EricRollei/Burningman_Camp_Shower_Control/assets/Shower system - Amazon.com.pdf

### Shower system

Title | Comments Price Quantity Has
DC HOUSE 2 Pack 12V 30Ah LiFePO4 Battery with DC Port for Trolling Motor | Low Temp Cut-Off,
4000+ Deep Cycle Rechargeable Battery, Ideal for Lighting, Solar, Camping, Ham Radio, Ride on Toy
by DC HOUSE (Electronics) |
$139.99 | 1 | 0

RVBOATPAT Power Distribution Block 12V 150A 1/4" Stud Marine Bus Bar 12 Volt DC Battery Busbar for Boat Automotive Solar Wiring
by RVBOATPAT (Unknown Binding) |
$16.99 | 1 | 0
MENTBERY Heat Shrink Ring Terminals 16-14 AWG 1/4" Stud Wire Connectors | 50 PCS, M6 Stud,
Waterproof Insulated Ring Connectors Tinned Copper, 16-14 Gauge Blue
by MENTBERY (Misc.) |
$7.99 | 1 | 0

BNTECHGO 18 Gauge Silicone Wire Spool Red and Black Each 100ft Flexible 18 AWG Stranded Tinned
Copper Wire | Flexible 18 Gauge Stranded Wire Silicone Rubber Insulation For RC Models, Drone,
Robot, Battery, EV Charger, 3D Printer, DIY
by BNTECHGO (Misc.) |
$34.98 | 1 | 0

Bolipoeq 30Amp Circuit Breaker DC 12V-48V for Marine Boat Trolling Motor Automotive RV Trailer Car Solar System Battery Disconnect with Manual Reset Switch, IP67 Waterproof (Pack of 4)
by Bolipoeq |
$29.99 | 1 | 0

BNTECHGO 18 Gauge Silicone Wire Spool Red 25ft and Black 25ft 2 Separate Wires Flexible 18 AWG
Stranded Tinned Copper Wire | Flexible 18 AWG Stranded Tinned Copper Wire Silicone Rubber
Insulation For RC Models, Drone, Robot, EV Charger, 3D Printer
by BNTECHGO (Misc.) |
$13.98 | 1 | 0
MENTBERY Heat Shrink Ring Terminals 22-16 AWG 1/4" Stud Wire Connectors | 50 PCS, M6 Stud,
Waterproof Insulated Ring Connectors Tinned Copper, 22-16 Gauge Red
by MENTBERY (Misc.) |
$5.99 | 1 | 0

Gasedin 2PCS DC 12-24 V Voltmeter Gauge, Mini Digital Display LED Voltage Meter Gauge with Round Panel, Waterproof Battery Monitor Indicator for Car Boat Marine Truck (Green)
by Gasedin (Tools & Home Improvement) |
$8.99 | 1 | 0

BEYIMEI DC 12V to 5V USB Buck Converter, DC 12V 24V Step Down to USB C, Type C Buck Converter 3A 15W Output, Power Voltage Converters with Fuse for Type-C Port Devices
by BEYIMEI |
$13.99 | 1 | 0
PAEKQ SB50 Anderson Battery Quick Connect/Disconnect Connector Cable 7AWG | 50A, Anderson to
O-Ring Terminal Cable, Heavy-Duty,12V-72V, Wire Harness Plug Kit,For Car Winch Trailer Forklift,1Pair
by PAEKQ |
$16.99 | 1 | 0
Nilight 2 Pin DT Connectors 16AWG 6 Kits Male&Female Electrical Connector | Waterproof Plug and
Play w/Heat Shrink Butt Terminals for Automotive Cars Truck Motorcycle Marine Boats
by Nilight (Misc.) |
$12.30 | 1 | 0

Lever Wire Connectors, HTCELLE 60-Piece Quick Connect Electrical Splicing Kit for Compact Inline Terminals - 28-12 AWG, 1 in 1 Out (Multicolored, 60)
by HTCELLE (Misc.) |
$9.99 | 1 | 0

Gasedin 2PCS DC 12-24 V Voltmeter Gauge, Mini Digital Display LED Voltage Meter Gauge with Round Panel, Waterproof Battery Monitor Indicator for Car Boat Marine Truck (Red)
by Gasedin |
$8.54 | 1 | 0

DaierTek 12 Way Fuse Block, 12 Volt Blade Fuse Block with LED Indicator 12 Circuit Fuse Box 12V ATO/ATC Marine Fuse Panel 24V with Waterproof Cover Fuse Terminals for Automotive Boat Car RV by DAIERTEK (Misc.) |

$15.99 | 1 | 0

2 Pcs LM2596s DC Buck Converter, MELIFE Adjustable DC to DC Step-down Voltage Regulator Power Module 36V 24V 12V to 5V 2A Voltage Stabilizer with LED Display
by MELIFE (Personal Computers) |
- | 1 | 0

CAMPLUX Portable Tankless Water Heater, 1.58 GPM Outdoor Propane Water Heater with 3.54'' S/S Rain Cap, for Camping, 41,000 BTU, BD158C
by CAMPLUX ENJOY OUTDOOR LIFE |
$179.99 | 1 | 1

SEAFLO Accumulator Tank Water Pump Flow Control with Internal Bladder - 125 PSI, 23.5 oz (0.75 L) | Reduces Pump Cycling and Smooths Water Flow for Marine, RV, and Off-Grid Systems

- | 1 | 1

Blissland Shower Hose Extra Long 90 Inches Brushed Chrome Handheld Shower Head Hose with Brass Insert and Nut - Lightweight and Flexible
by Blissland (Tools & Home Improvement) |
$12.99 | 1 | 1

12V 20AH LiFePO4 Lithium Battery, Built-in 20A BMS, 5000+ Cycles Rechargeable Deep Cycle Battery, Perfect for Solar Power, Small UPS, Gate Opener, Fish Finder, Outdoor Camping

- | 1 | 1
USA Adventure Gear 3200 RV Water Pump | High Pressure Strong Flow | Quiet Operation |
Professional Grade Heavy Duty Construction | 3.2GPM 55PSI 12V DC 8A | Assembled in the USA Black
by USA Adventure Gear (Automotive) |
- | 1 | 0

5-pin 40/30Amp 12V DC Waterproof Automotive Relay with Heavy-Duty Wire
by iRhapsody (Tools & Home Improvement) |
$25.99 | 1 | 0
ECO-WORTHY 12V 10A Battery Charger for Lead-Acid, LiFePO4 Battery | Battery Maintainer, Trickle
Charger with LCD Screen for RV, Car, Motorcycle, Marine, Boat
by ECO-WORTHY |
$64.99 | 2 | 1
BesNPT 1/2" Male Thread Brass 3 Way Shut Off Valve Y Shaped Ball Valve | 3-Way Y Shaped 2 Switch
Ball Valve Solid Brass Corrosion Resistant Easy Installation
by BesNPT (Tools & Home Improvement) |
$13.99 | 1 | 0

SUNGATOR 1-Inch NPT Brass Hose Barb Fittings, 1'' NPT Male Thread to 1'' Barbed Air Hose Fittings, 1-Inch Brass Air Line Repair Connectors for Compressor, Fuel, Oil (2-Pack)
by SUNGATOR |
$10.99 | 1 | 0
DAVCO 1/2" ID 25 ft Reinforced Vinyl Tubing Clear PVC Suction Vacuum Hose | Flexible, non
collapsible, Heavy Duty, high pressure, Spiral steel wire reinforced vacuum line pipe, plastic tube, Non-Toxic
by DAVCO (Tools & Home Improvement) |
$25.99 | 1 | 0
Waterdrop 10UA Under Sink Water Filter System, NSF/ANSI 42 Certified 1 Year | Reduces PFAS,
PFOA/PFOS, Lead, Chlorine, Bad Taste & Odor, Under Counter Water Filter Connects Directly to Your Faucet
by Waterdrop (Tools & Home Improvement) |
$43.99 | 1 | 0

SNGSPK 304 Stainless Steel 5-Way Internal Threaded Connector - 1" NPT Multi-Branch - Precision CNC Machined for Industrial Pipeline Grid - Pack of 1
by SNGSPK (Tools & Home Improvement) |
- | 1 | 0

Shurflo 255-213 1/2" MNPT x FNPT Inline Strainer for 2088 Series Pumps
by SHURFLO (Tools & Home Improvement) |
$7.95 | 1 | 0

SEAFLO 42 Series 12V RV Water Pump, 3.0 GPM 55 PSI, 4-Year Warranty, On-Demand Fresh Water Pressure Pump with Bypass, Self-Priming for RVs, Boats, Marine & Off-Grid Use, UL Listed
by SEAFLO (Tools & Home Improvement) |
$64.99 | 1 | 0
Midanya 24" Sink Hose, 1/2" FIP x 1/2" FIP Faucet Supply Lines,2 Pcs | cUPC Stainless Steel
Braided,SUS304,for Bathroom,Kitchen,RV,Farmhouse,Easy Install,1 Pair Faucet Hose
by Midanya (Tools & Home Improvement) |
$11.99 | 1 | 0

See more (https://www.amazon.com/hz/wishlist/printview/MYFX98APBG9S?ajax=false&filter=unpurchased&sort=date-added)
