EricRollei/Burningman_Camp_Shower_Control/BOM.md

# Bill of Materials (BOM)

Per-shower bill of materials. The camp builds **two independent
stations**, so most quantities are **×2** (some multi-packs cover both).

> Status legend: ✅ selected · 🔍 searching · ❓ undecided · ⚠️ note / decision
>
> Prices are Amazon list prices (USD) captured from the
> [wishlist](https://www.amazon.com/hz/wishlist/ls/MYFX98APBG9S) and will
> drift. Items marked **(alt)** are alternatives not counted in the
> subtotal.

------------------------------------------------------------------------

## Power & Charging

| Item | Spec / Part | Qty | Status | Unit $ | Vendor / Link | Notes |
|---|---|:---:|:---:|:---:|---|---|
| Battery | DC HOUSE 12V 30Ah LiFePO₄ (2-pack) | 1 | ✅ | $139.99 /2-pack | [B0DHZPPKQS](https://www.amazon.com/dp/B0DHZPPKQS) | 2-pack covers both stations. Was speced 40Ah |
| Battery (alt) | 12V 20Ah LiFePO₄, built-in 20A BMS | — | 🔍 | — | [B0CY1RWLXR](https://www.amazon.com/dp/B0CY1RWLXR) | Smaller alternative |
| AC charger | ECO-WORTHY 12V 10A (Lead/LiFePO₄), LCD | 1 | ✅ | $64.99 | [B09ZQFDRZN](https://www.amazon.com/dp/B09ZQFDRZN) | Generator-fed |
| AC charger (alt) | ECO-WORTHY 12V 5A, LCD | — | 🔍 | $45.99 | [B08T95FF8K](https://www.amazon.com/dp/B08T95FF8K) | Slower alternative |
| Battery monitor | Gasedin mini LED voltmeter (2-pack, green) | 1 | ✅ | $8.99 /2-pack | [B0F4XGZVSP](https://www.amazon.com/dp/B0F4XGZVSP) | Voltage-only (not coulomb) |
| Battery monitor (alt) | Gasedin voltmeter (2-pack, red) | — | 🔍 | $8.54 /2-pack | [B0F4XBGJMV](https://www.amazon.com/dp/B0F4XBGJMV) | Color variant |
| Controller 5V supply | MELIFE LM2596 12V→5V buck (2-pack) | 1 | ✅ | see listing | [B08977C9YM](https://www.amazon.com/dp/B08977C9YM) | For 5V into PaHub (see open decision) |
| Solar panel | 50 W 12V | 1 | 🔍 | | | Not on list yet |
| Solar charge controller | 12V MPPT/PWM | 1 | 🔍 | | | Size to panel |

## Protection & Distribution

| Item | Spec / Part | Qty | Status | Unit $ | Vendor / Link | Notes |
|---|---|:---:|:---:|:---:|---|---|
| Main breaker | Bolipoeq 30A manual-reset (4-pack) | 1 | ✅ | $29.99 /4-pack | [B0DHCGYGJM](https://www.amazon.com/dp/B0DHCGYGJM) | Main disconnect; IP67 |
| Fuse block | DaierTek 12-way ATO/ATC, LED, waterproof | 1 | ✅ | $15.99 | [B0CGT91KTR](https://www.amazon.com/dp/B0CGT91KTR) | Fused branch distribution |
| Busbar | RVBOATPAT 150A 1/4" stud marine busbar | 1 | ✅ | $16.99 | [B0CF1N8FM8](https://www.amazon.com/dp/B0CF1N8FM8) | Negative / common bus |
| Fuses | ATO/ATC assortment (15/10/5/3–5A) | — | 🔍 | | | See Wiring.md |

## Pump & Plumbing (water path)

| Item | Spec / Part | Qty | Status | Unit $ | Vendor / Link | Notes |
|---|---|:---:|:---:|:---:|---|---|
| Pump | SEAFLO 42-Series 12V, 3.0 GPM, 55 PSI | 1 | ✅ | $64.99 | [B01CQ7DD0S](https://www.amazon.com/dp/B01CQ7DD0S) | UL listed; self-priming |
| Pump (alt) | USA Adventure Gear 3200, 3.2 GPM 55 PSI 8A | — | 🔍 | — | [B07BVSD4PF](https://www.amazon.com/dp/B07BVSD4PF) | Alternative pump |
| Accumulator | SEAFLO 0.75 L, 125 PSI | 1 | ✅ | $35.99 | [B01MUYL8F8](https://www.amazon.com/dp/B01MUYL8F8) | Smooths cycling |
| Inline strainer | Shurflo 255-213 1/2" for 2088 pumps | 1 | ✅ | $7.95 | [B00IU0N5ZO](https://www.amazon.com/dp/B00IU0N5ZO) | Pump-inlet filter |
| Water filter (opt) | Waterdrop 10UA under-sink | — | 🔍 | $43.99 | [B083NPW1DN](https://www.amazon.com/dp/B083NPW1DN) | Optional fine filter |
| Water heater | ⚠️ CAMPLUX tankless **propane**, 1.58 GPM, 41k BTU | 1 | ✅ | $179.99 | [B097JTWBGH](https://www.amazon.com/dp/B097JTWBGH) | Propane, not 12V — see note |
| Mixing valve | Thermostatic 1/2" NPT brass | 1 | ✅ | $29.99 | [B0C9TKWMN8](https://www.amazon.com/dp/B0C9TKWMN8) | Temp control |
| Flow sensor | SENSTREE G1/2" Hall, 1–30 L/min | 1 | ✅ | $8.99 | [B0CC949527](https://www.amazon.com/dp/B0CC949527) | Pulse output; Arduino-compatible |
| Foot pump (opt) | GHmarine 2147 manual, 1/2" hose | — | 🔍 | $29.99 | [B09VBX7ZDJ](https://www.amazon.com/dp/B09VBX7ZDJ) | Manual backup / sink |
| Tank | 500 gal (shared/camp) | 1 | ✅ | | | Shared resource |

## Plumbing Fittings & Hose

| Item | Spec / Part | Qty | Status | Unit $ | Vendor / Link | Notes |
|---|---|:---:|:---:|:---:|---|---|
| Cold-bypass valve | BesNPT 1/2" brass 3-way Y ball valve | 1 | ✅ | $13.99 | [B0CT8BL9V9](https://www.amazon.com/dp/B0CT8BL9V9) | Cold bypass / blend |
| Shower hose | Blissland 90" handheld, brushed chrome | 1 | ✅ | $12.99 | [B0B62QF1Q2](https://www.amazon.com/dp/B0B62QF1Q2) | |
| Supply hose | Midanya 24" 1/2" FIP braided (2-pack) | 1 | ✅ | $11.99 | [B0CZR5N4P3](https://www.amazon.com/dp/B0CZR5N4P3) | |
| Short supply hose | Midanya 9" 1/2" FIP × 1/2" FIP braided SS (2-pack) | 3 | ✅ | $12.59 /2-pack | [B0GT4WHS46](https://www.amazon.com/dp/B0GT4WHS46) | Need 5; 3 packs = 6 (1 spare) |
| Suction tubing | DAVCO 1/2" ID reinforced vinyl, 25 ft | 1 | ✅ | $25.99 | [B09W4KSB5X](https://www.amazon.com/dp/B09W4KSB5X) | Tank feed |
| Suction hose (1") | DAVCO 1" ID wire-reinforced PVC, 25 ft | 1 | ✅ | $44.99 | [B0F1TKPPDR](https://www.amazon.com/dp/B0F1TKPPDR) | Larger low-restriction tank suction |
| Hose barb | SUNGATOR 1" NPT male barb (2-pack) | 1 | ✅ | $10.99 | [B0CLY4WNJ7](https://www.amazon.com/dp/B0CLY4WNJ7) | Tank fitting |
| Manifold (opt) | SNGSPK 304 SS 5-way 1" NPT | — | 🔍 | — | [B0FLTW68VT](https://www.amazon.com/dp/B0FLTW68VT) | Distribution branch |

## Control Electronics

| Item | Spec / Part | Qty | Status | Unit $ | Vendor / Link | Notes |
|---|---|:---:|:---:|:---:|---|---|
| Controller | M5Stack Tough ESP32 (2.0" touch, IP-rated) | 1 | ✅ | $64.90 | [B0C7GL8RP8](https://www.amazon.com/dp/B0C7GL8RP8) | 12V via RS485 conn. |
| I²C hub | M5Stack PaHub v2.1 (PCA9548A, 6-port) | 1 | ✅ | $15.99 | [B0G5N1FSNG](https://www.amazon.com/dp/B0G5N1FSNG) | Grove I²C expansion |
| RFID/NFC reader | M5Stack RFID2 (WS1850S, 13.56 MHz) | 1 | ✅ | — | [B0F3N3XMDM](https://www.amazon.com/dp/B0F3N3XMDM) | MIFARE / NTAG compatible |
| Relay unit | M5Stack 4Relay (10A/16A, I²C) | 1 | ✅ | $29.99 | [B0H27XRW4T](https://www.amazon.com/dp/B0H27XRW4T) | Grove; incl. 3.96 terminals |
| Automotive relay | 5-pin 40/30A 12V waterproof, w/ harness | 1 | ✅ | $25.99 | [B074FSZWVT](https://www.amazon.com/dp/B074FSZWVT) | Pump switching |
| SD card | For CSV logs | 1 | 🔍 | | | Not on list |
| RTC | Real-time clock | 1 | ❓ | | | For log timestamps |

## Charging & Accessories

| Item | Spec / Part | Qty | Status | Unit $ | Vendor / Link | Notes |
|---|---|:---:|:---:|:---:|---|---|
| USB-C buck converter | BEYIMEI 12V→5V USB-C, 3A/15W, fused | 1 | ✅ | $13.99 | [B0D3THTQJK](https://www.amazon.com/dp/B0D3THTQJK) | Session-gated |
| USB-C panel outlet | | 1 | 🔍 | | | |
| LED strip | 12V addressable, 2 m | 1 | 🔍 | | | 120 individually addressable pixels confirmed on bench |

## Connectors, Wire & Terminals

| Item | Spec / Part | Qty | Status | Unit $ | Vendor / Link | Notes |
|---|---|:---:|:---:|:---:|---|---|
| Anderson SB50 | PAEKQ 50A cable, 7 AWG, O-ring (pair) | 1 | ✅ | $16.99 /pair | [B0F6L9L9GG](https://www.amazon.com/dp/B0F6L9L9GG) | Battery quick-disconnect |
| Deutsch DT (pump) | Nilight 2-pin DT 16 AWG (6 kits) | 1 | ✅ | $12.30 | [B0CMQHQ3LL](https://www.amazon.com/dp/B0CMQHQ3LL) | Waterproof |
| Lever connectors | HTCELLE 28-12 AWG splice kit (60 pc) | 1 | ✅ | $9.99 | [B0C3LBWSTZ](https://www.amazon.com/dp/B0C3LBWSTZ) | Quick splices |
| Silicone wire | BNTECHGO 18 AWG red+black, 100 ft ea | 1 | ✅ | $34.98 | [B091GHDSH8](https://www.amazon.com/dp/B091GHDSH8) | Controller power |
| Silicone wire | BNTECHGO 18 AWG red+black, 25 ft ea | 1 | ✅ | $13.98 | [B01C5CANVG](https://www.amazon.com/dp/B01C5CANVG) | Signals / jumpers |
| Ring terminals | MENTBERY 16-14 AWG 1/4" stud (50 pc, blue) | 1 | ✅ | $7.99 | [B0BWJ8G5P9](https://www.amazon.com/dp/B0BWJ8G5P9) | |
| Ring terminals | MENTBERY 22-16 AWG 1/4" stud (50 pc, red) | 1 | ✅ | $5.99 | [B0BWJ92F6G](https://www.amazon.com/dp/B0BWJ92F6G) | |
| SAE fused pigtail | BFXM 10 AWG SAE↔ring, 15/20A fuse (2-pack) | 1 | ✅ | $12.99 | [B0D66QVPQK](https://www.amazon.com/dp/B0D66QVPQK) | Quick-disconnect / solar / charger |
| MC4 (solar) | Solar connectors | 1 | 🔍 | | | Not on list |
| Grove | I²C device cables | — | 🔍 | | | Not on list |
| Wire 12/16 AWG | Power runs (pump/main/lighting) | — | 🔍 | | | See Wiring.md gauges |

Gauge plan (see [Wiring.md](Wiring.md)): battery/main & pump 12 AWG,
lighting 16 AWG, controller 18 AWG, signals 22 AWG.

## RFID / NFC Tags

| Tag | Purpose | Status | Unit $ | Vendor / Link |
|-----|---|:---:|:---:|---|
| NTAG213 | Candidate | 🔍 test | | |
| NTAG215 | Candidate | 🔍 test | | |
| NTAG216 | Candidate | 🔍 test | | |

------------------------------------------------------------------------

## Cost Summary

Selected primary items from the
[Amazon wishlist](https://www.amazon.com/hz/wishlist/ls/MYFX98APBG9S)
(list prices; **alt/optional** items excluded; some are multi-packs that
cover both stations):

| Subsystem | Selected items | Subtotal $ |
|---|---|---:|
| Power & charging | Battery 2-pack, 10A charger, voltmeter, LM2596 | 213.97* |
| Protection & distribution | 30A breaker 4-pack, 12-way fuse block, busbar | 62.97 |
| Pump & plumbing | Pump, accumulator, strainer, heater, mixing valve, flow sensor | 327.90 |
| Plumbing fittings & hose | Y valve, shower hose, supply hose, 3× 9" hose, tubing, 1" suction hose, hose barb | 158.71 |
| Control | M5Stack Tough, PaHub, RFID2, 4Relay, automotive relay | 136.87** |
| Accessories | USB-C buck converter | 13.99 |
| Connectors, wire, terminals | Anderson, DT, lever, SAE pigtail, 2× wire, 2× ring terminals | 115.21 |
| **Selected subtotal** | | **≈ $1,029.62** |

\* LM2596 price not shown on the wishlist; excluded from the number.
\*\* RFID2 price not shown on the wishlist; excluded from the number.

**Not yet on the list / still to source:** solar panel, solar charge
controller, SD card, RTC, USB-C panel outlet, LED strip, 12/16 AWG power
wire, MC4 & Grove connectors, ATO/ATC fuse assortment, NFC tags.

**Alternates & optional (not in subtotal):** 20Ah battery, 5A charger,
red voltmeter, USA Adventure Gear pump, Waterdrop under-sink filter,
GHmarine foot pump, SNGSPK 5-way manifold.
