EricRollei/Burningman_Camp_Shower_Control/firmware/shower-controller/src/main.cpp

#include <M5Unified.h>
#include <SD.h>
#include <Wire.h>
#include <WiFi.h>
#include <esp_system.h>
#include <esp_ota_ops.h>
#include <esp_task_wdt.h>

#include "AdminServer.h"
#include "CampNet.h"
#include "Config.h"
#include "FlowMeter.h"
#include "I2cHub.h"
#include "LightShow.h"
#include "MemberRegistry.h"
#include "PulseStorage.h"
#include "RelayController.h"
#include "RfidReader.h"
#include "SessionStorage.h"
#include "SettingsStore.h"
#include "SpeakerAudio.h"
#include "StationDisplay.h"
#include "StorageWrite.h"
#include "UsageLedger.h"

extern "C" bool verifyRollbackLater() { return true; }

namespace {
enum class ScreenState { IDLE, ACTIVE, MUSIC_CHANNEL, MESSAGE, CALIBRATION };

FlowMeter flow;
PulseStorage pulseStorage;
MemberRegistry members;
SessionStorage sessions;
SettingsStore settings;
SpeakerAudio speakerAudio;
UsageLedger ledger;
CampNetLink campNet(members, sessions, settings, ledger);
AdminServer admin(members, pulseStorage, sessions, settings, speakerAudio, ledger, campNet);
RelayController relays;
RfidReader rfid;
I2cHub i2cHub;
LightShow lightShow;
StationDisplay stationDisplay;

ScreenState screenState = ScreenState::IDLE;
char activeUid[21] = {0};
char activeName[33] = {0};
char lastScannedUid[21] = {0};
uint32_t lastScanMs = 0;
uint32_t lastRfidPollMs = 0;
uint32_t lastLogMs = 0;
uint32_t lastSensorTotal = 0;
uint32_t pendingPulses = 0;
uint32_t sessionPulses = 0;
uint32_t sessionStartMs = 0;
uint32_t messageUntilMs = 0;
uint32_t calibrationStartPulses = 0;
uint32_t calibrationStartMs = 0;
uint32_t lastBusProbeMs = 0;
uint32_t buttonChangedMs = 0;
uint32_t buttonPressedMs = 0;
uint32_t lastMusicKnobReadMs = 0;
uint32_t lastMusicKnobLogMs = 0;
uint32_t lastMusicStartAttemptMs = 0;
uint32_t lastMusicMovementMs = 0;
uint32_t musicChannelUntilMs = 0;
uint16_t musicKnobRaw = 0;
uint16_t musicMotionReferenceRaw = 0;
uint16_t musicCalibrationPositions[Config::MUSIC_KNOB_POSITION_COUNT] = {0};
float activeAllowance = 0.0F;
uint32_t activeTimeoutMs = 0;
float summaryGallons = 0.0F;
uint32_t summaryElapsedMs = 0;
// Camp-wide totals for the wristband that just finished (this station + every
// other station's last snapshot), shown on the summary screen.
float summaryTotalGallons = 0.0F;
uint32_t lastRemoteChangeCount = 0;
bool rfidReady = false;
bool relayReady = false;
bool hubReady = false;
uint8_t hubAddress = Config::PAHUB_ADDRESS;
int8_t relayChannel = -1;
int8_t rfidChannel = -1;
bool calibrationActive = false;
bool relayTestActive = false;
uint8_t relayTestChannel = 0;
uint32_t relayTestStartMs = 0;
bool pumpMaybeStuck = false;
uint32_t lastEmergencyRecoveryMs = 0;
uint8_t bootRelayState = 0;
bool bootRelayStateKnown = false;
bool screenDirty = true;
bool buttonRawPressed = false;
bool buttonStablePressed = false;
bool buttonPressArmed = false;
bool buttonStoppedPump = false;
char buttonPressUid[21] = {0};
bool musicStartPending = false;
bool musicKnobMoving = false;
bool musicStaticStarted = false;
bool musicCalibrationActive = false;
bool summaryReady = false;
bool summaryLogged = false;
bool otaPendingVerification = false;
uint32_t otaVerificationLoopStartMs = 0;
uint32_t otaLastRollbackAttemptMs = 0;
uint8_t musicCalibrationNextPosition = 0;
int8_t musicChannel = -1;
String musicCalibrationMessage = "Ready to calibrate";
String messageTitle;
String messageBody;
String serialCommand;

bool sessionActive() { return activeUid[0] != '\0'; }

void markRelayFailure() {
  // A failed write leaves the module latched in its last state; only a
  // successful all-off proves the pump is no longer powered.
  pumpMaybeStuck = !relays.allOff();
  relayReady = false;
}

bool setConfiguredRelay(uint8_t channel, bool on) {
  if (channel == 0) return true;
  if (!relayReady || !relays.set(channel, on)) {
    markRelayFailure();
    return false;
  }
  return true;
}

bool shutdownAllRelays() {
  if (!relayReady) return false;
  if (!relays.allOff()) {
    relayReady = false;
    pumpMaybeStuck = true;
    return false;
  }
  pumpMaybeStuck = false;
  return true;
}

bool applyAccessoryPolicy() {
  const SettingsStore::RelayConfig& config = settings.relayConfig();
  return !config.accessoryEnabled || config.accessory == 0 ||
         setConfiguredRelay(config.accessory, true);
}

void stopPump() {
  setConfiguredRelay(settings.relayConfig().pump, false);
}

void stopSessionOutputs() {
  const SettingsStore::RelayConfig& config = settings.relayConfig();
  if (!setConfiguredRelay(config.pump, false)) return;
  setConfiguredRelay(config.charger, false);
}

uint8_t doorDisplayState() {
  if (sessionActive()) return CampNet::DOOR_IN_USE;
  if (admin.otaMaintenanceActive() || calibrationActive || relayTestActive ||
      !pulseStorage.healthy() || !sessions.healthy() ||
      !settings.healthy() || !relayReady || !rfidReady) return CampNet::DOOR_UNAVAILABLE;
  return CampNet::DOOR_OPEN;
}

// Session limits for a wristband at this station: a member's own shower
// allowance (if set) overrides the shower limit; fills always use the role
// limit. Time limits always come from the role.
float effectiveAllowanceFor(const char* uid) {
  const float roleLimit = settings.roleLimits(Config::STATION_ROLE_VALUE).gallons;
  const float memberLimit = members.allowanceFor(uid);
  if (Config::IS_SHOWER && memberLimit > 0.0F) return memberLimit;
  return roleLimit > 0.0F ? roleLimit : Config::DEFAULT_ROLE_LIMIT_GALLONS[Config::STATION_ROLE_VALUE];
}

uint32_t effectiveTimeoutMs() {
  uint16_t minutes = settings.roleLimits(Config::STATION_ROLE_VALUE).minutes;
  if (minutes < Config::MIN_LIMIT_MINUTES || minutes > Config::MAX_LIMIT_MINUTES) {
    minutes = Config::DEFAULT_ROLE_LIMIT_MINUTES[Config::STATION_ROLE_VALUE];
  }
  return static_cast<uint32_t>(minutes) * 60UL * 1000UL;
}

void serviceCampNet() {
  campNet.setDoorState(doorDisplayState(), sessionActive());
  campNet.handle();
  ledger.handle();
  // Limits or members adopted from another station change what the idle
  // screen advertises.
  if (campNet.remoteChangeCount() != lastRemoteChangeCount) {
    lastRemoteChangeCount = campNet.remoteChangeCount();
    screenDirty = true;
  }
}

float gallonsFor(uint32_t pulses) {
  const float calibration = settings.pulsesPerGallon();
  return calibration > 0.0F ? pulses / calibration : 0.0F;
}

void setMessage(const String& title, const String& body, uint32_t durationMs = 3500) {
  summaryReady = false;
  messageTitle = title;
  messageBody = body;
  messageUntilMs = millis() + durationMs;
  screenState = ScreenState::MESSAGE;
  screenDirty = true;
  Serial.printf("[STATUS] %s: %s\n", title.c_str(), body.c_str());
}

String uidToHex(const uint8_t* uid, int length) {
  char hex[21] = {0};
  for (int i = 0; i < length && i < 10; ++i) snprintf(hex + i * 2, sizeof(hex) - i * 2, "%02X", uid[i]);
  return String(hex);
}

bool displayReady() {
  return pulseStorage.healthy() && sessions.healthy() && settings.healthy() &&
         relayReady && rfidReady;
}

void drawScreen() {
  const bool ready = displayReady();
  const uint8_t peers = campNet.peerCount();
  if (screenState == ScreenState::IDLE) {
    stationDisplay.drawIdle(Config::STATION_ROLE_VALUE, ready, peers);
  } else if (screenState == ScreenState::ACTIVE) {
    const bool pumpOn = relays.isOn(settings.relayConfig().pump);
    const float burnTotal = sessions.gallonsFor(activeUid) +
                            ledger.remoteGallonsFor(activeUid);
    stationDisplay.drawSession(Config::STATION_ROLE_VALUE, activeName, burnTotal,
                               gallonsFor(sessionPulses), millis() - sessionStartMs,
                               pumpOn, ready, peers);
  } else if (screenState == ScreenState::MUSIC_CHANNEL) {
    const uint8_t channel = musicChannel >= 0 ?
        static_cast<uint8_t>(musicChannel) : 0;
    stationDisplay.drawMusicChannel(
        Config::STATION_ROLE_VALUE, channel,
        Config::MUSIC_CHANNEL_NAMES[channel],
        relays.isOn(settings.relayConfig().pump), ready, peers);
  } else if (screenState == ScreenState::CALIBRATION) {
    const uint32_t pulses = flow.totalPulses() - calibrationStartPulses;
    stationDisplay.drawCalibration(pulses, ready, peers);
  } else {
    if (summaryReady) {
      stationDisplay.drawSummary(Config::STATION_ROLE_VALUE, summaryGallons,
                                 summaryTotalGallons, summaryElapsedMs,
                                 summaryLogged, ready, peers);
    } else {
      stationDisplay.drawMessage(Config::STATION_ROLE_VALUE, messageTitle,
                                 messageBody, ready, peers);
    }
  }
  screenDirty = false;
}

void discoverI2cDevices() {
  if (!hubReady) {
    for (uint8_t address = 0x70; address <= 0x77 && !hubReady; ++address) {
      hubReady = i2cHub.begin(Wire, address);
      if (hubReady) hubAddress = address;
    }
  }
  if (!hubReady) return;

  if (!relayReady) {
    relayChannel = i2cHub.findDevice(Config::RELAY_ADDRESS);
    relayReady = relayChannel >= 0 && relays.begin(Wire, Config::RELAY_ADDRESS, &i2cHub, relayChannel);
    if (relayReady && !applyAccessoryPolicy()) relayReady = false;
  }
  if (!rfidReady) {
    rfidChannel = i2cHub.findDevice(Config::RFID_ADDRESS);
    rfidReady = rfidChannel >= 0 && rfid.begin(Wire, Config::RFID_ADDRESS, &i2cHub, rfidChannel);
  }
}

void serviceI2cRecovery() {
  if (millis() - lastBusProbeMs < 5000 || sessionActive() || calibrationActive ||
      relayTestActive || pumpMaybeStuck) return;
  lastBusProbeMs = millis();
  // A reader that lost power comes back with its antenna off and reads 0
  // forever unless begin() runs again.
  if (rfidReady && !rfid.healthy()) {
    Serial.println("[I2C] RFID reader stopped responding; re-initialising");
    rfidReady = false;
  }
  if (hubReady && relayReady && rfidReady) return;
  // Re-open the hub before probing: a NACK latches I2cHub::healthy_ false (so
  // findDevice() always fails) and a re-plugged PaHUB resets its channel
  // register while the cached selectedChannel_ still says otherwise.
  if (hubReady) hubReady = i2cHub.begin(Wire, hubAddress);
  discoverI2cDevices();
}

bool flushPulses() {
  if (!sessionActive() || pendingPulses == 0) return true;
  const uint32_t delta = pendingPulses;
  if (!pulseStorage.recordPulses(activeUid, delta)) return false;
  pendingPulses = 0;
  return true;
}

void endSession(const char* reason) {
  if (!sessionActive()) return;
  stopSessionOutputs();
  if (Config::HAS_MUSIC) speakerAudio.stop();
  musicStartPending = false;
  musicKnobMoving = false;
  musicStaticStarted = false;
  musicMotionReferenceRaw = musicKnobRaw;
  const bool rawLogged = flushPulses() && pulseStorage.endTag(activeUid);
  const uint32_t endMs = millis();
  summaryGallons = gallonsFor(sessionPulses);
  summaryElapsedMs = endMs - sessionStartMs;
  const bool sessionLogged = sessions.append(sessionStartMs, endMs, activeUid,
                                             sessionPulses, summaryGallons,
                                             activeAllowance, reason);
  const bool logged = rawLogged && sessionLogged;
  // Camp-wide total: this station's completed sessions (now including this
  // one) plus the latest snapshot from every other station.
  summaryTotalGallons = sessions.gallonsFor(activeUid) +
                        ledger.remoteGallonsFor(activeUid);
  campNet.markUsageDirty();
  Serial.printf("[SESSION] end uid=%s pulses=%lu gallons=%.4f reason=%s logged=%s total=%.2f\n",
                activeUid, static_cast<unsigned long>(sessionPulses), summaryGallons,
                reason, logged ? "yes" : "no", summaryTotalGallons);
  activeUid[0] = '\0'; activeName[0] = '\0'; pendingPulses = 0; sessionPulses = 0;
  setMessage(logged ? Config::ROLE_COMPLETE_LABELS[Config::STATION_ROLE_VALUE] : "LOGGING ERROR",
             logged ? "Thank you!" : "Tell a camp admin", Config::SUMMARY_DISPLAY_MS);
  summaryLogged = logged;
  summaryReady = true;
}

void rebootController(const char* source) {
  Serial.printf("[SYSTEM] reboot requested from %s\n", source);
  if (sessionActive()) endSession("REBOOT");
  shutdownAllRelays();
  admin.handle();  // Give a pending HTTP response a chance to flush.
  delay(250);
  ESP.restart();
}

// Safety path: relay control was lost while water could be flowing (active
// session, calibration, or relay test), or a pump-off write was never
// confirmed. Keeps retrying until the module answers again; a successful
// RelayController::begin() forces every output off, which is the pump kill.
void serviceRelayEmergency() {
  const bool outputsInUse = sessionActive() || calibrationActive || relayTestActive;
  const bool controlLost = !relayReady || !hubReady;
  if (!pumpMaybeStuck && !(controlLost && outputsInUse)) return;
  const uint32_t now = millis();
  if (now - lastEmergencyRecoveryMs < Config::RELAY_EMERGENCY_RETRY_MS) return;
  lastEmergencyRecoveryMs = now;
  Serial.printf("[SAFETY] relay recovery: hub=%s relay=%s stuck=%s session=%s\n",
                hubReady ? "ok" : "fail", relayReady ? "ok" : "fail",
                pumpMaybeStuck ? "yes" : "no", sessionActive() ? "yes" : "no");

  Wire.beginTransmission(hubAddress);
  if (Wire.endTransmission() != 0) {
    i2cBusRecover(Wire, Config::I2C_SDA, Config::I2C_SCL, Config::I2C_FREQUENCY);
  }
  hubReady = i2cHub.begin(Wire, hubAddress);
  if (!hubReady) {
    for (uint8_t address = 0x70; address <= 0x77 && !hubReady; ++address) {
      hubReady = i2cHub.begin(Wire, address);
      if (hubReady) hubAddress = address;
    }
  }
  relayReady = false;
  if (hubReady) {
    relayChannel = i2cHub.findDevice(Config::RELAY_ADDRESS);
    relayReady = relayChannel >= 0 &&
                 relays.begin(Wire, Config::RELAY_ADDRESS, &i2cHub, relayChannel);
  }
  if (!relayReady) return;  // keep retrying on the next cadence tick
  pumpMaybeStuck = false;
  Serial.println("[SAFETY] relay control recovered; all outputs forced off");
  if (relayTestActive) {
    relayTestActive = false;
    relayTestChannel = 0;
  }
  if (calibrationActive) {
    calibrationActive = false;
    admin.reportCalibration(false, 0, "Stopped by relay recovery");
  }
  if (sessionActive()) endSession("RELAY_RECOVERY");
  if (!applyAccessoryPolicy()) relayReady = false;
  screenDirty = true;
}

void serviceOtaBootVerification() {
  if (!otaPendingVerification) return;
  const uint32_t now = millis();
  if (otaVerificationLoopStartMs == 0) otaVerificationLoopStartMs = now;
  if (now - otaVerificationLoopStartMs >= Config::OTA_HEALTHY_AFTER_MS &&
      campNet.ready() && admin.started()) {
    const esp_err_t result = esp_ota_mark_app_valid_cancel_rollback();
    if (result == ESP_OK) {
      otaPendingVerification = false;
      Serial.printf("[OTA] boot verified commit=%s dirty=%s\n",
                    Config::FIRMWARE_COMMIT, Config::FIRMWARE_DIRTY ? "yes" : "no");
    } else {
      Serial.printf("[OTA] could not mark image valid: %s\n", esp_err_to_name(result));
    }
    return;
  }
  if (now < Config::OTA_ROLLBACK_AFTER_MS) return;
  if (otaLastRollbackAttemptMs != 0 && now - otaLastRollbackAttemptMs < 5000) return;
  otaLastRollbackAttemptMs = now;
  Serial.println("[OTA] boot health deadline missed; rolling back");
  if (Config::HAS_MUSIC) speakerAudio.stop();
  shutdownAllRelays();
  const esp_err_t result = esp_ota_mark_app_invalid_rollback_and_reboot();
  Serial.printf("[OTA] rollback failed: %s\n", esp_err_to_name(result));
  setMessage("UPDATE FAILED", "USB recovery required", 30000);
}

bool serviceOtaLifecycle() {
  if (admin.takeOtaPrepareRequest()) {
    if (Config::HAS_MUSIC) speakerAudio.stop();
    musicStartPending = false;
    musicKnobMoving = false;
    musicStaticStarted = false;
    const bool relaysOff = shutdownAllRelays();
    if (Config::HAS_LED_STRIP) lightShow.handle(speakerAudio, false);
    setMessage(relaysOff ? "SOFTWARE UPDATE" : "UPDATE FAILED",
               relaysOff ? "Keep power on" : "Could not turn relays off",
               Config::OTA_ARM_TIMEOUT_MS + 10000UL);
    admin.confirmOtaPrepared(relaysOff);
  }

  if (admin.takeOtaRecoveryRequest()) {
    shutdownAllRelays();
    if (relayReady && !applyAccessoryPolicy()) relayReady = false;
    setMessage("UPDATE FAILED", "Old firmware is still active", 5000);
  }
  if (admin.takeOtaRebootRequest()) rebootController("OTA update");
  if (!admin.otaMaintenanceActive()) return false;

  if (Config::HAS_MUSIC) speakerAudio.stop();
  if (Config::HAS_LED_STRIP) lightShow.handle(speakerAudio, false);
  serviceCampNet();
  if (screenDirty) drawScreen();
  delay(5);
  return true;
}

void startSession(const String& uid) {
  const char* name = members.nameFor(uid.c_str());
  if (name == nullptr || !members.enabledFor(uid.c_str())) {
    summaryGallons = 0.0F; summaryElapsedMs = 0;
    setMessage("NOT AUTHORIZED", name ? "Wristband disabled" : "See a camp admin");
    return;
  }
  if (!pulseStorage.healthy() || !sessions.healthy() || !settings.healthy()) {
    summaryGallons = 0.0F; summaryElapsedMs = 0;
    setMessage("UNAVAILABLE", "Usage storage needs service");
    return;
  }
  // Authentication opens a session; an explicit physical or touchscreen
  // button activation starts water flow.
  if (!setConfiguredRelay(settings.relayConfig().pump, false)) {
    summaryGallons = 0.0F; summaryElapsedMs = 0;
    setMessage("UNAVAILABLE", "Pump control needs service");
    return;
  }
  strlcpy(activeUid, uid.c_str(), sizeof(activeUid));
  strlcpy(activeName, name, sizeof(activeName));
  activeAllowance = effectiveAllowanceFor(activeUid);
  activeTimeoutMs = effectiveTimeoutMs();
  pendingPulses = 0; sessionPulses = 0; sessionStartMs = millis(); lastLogMs = millis();
  if (!pulseStorage.selectTag(activeUid)) {
    stopSessionOutputs();
    activeUid[0] = '\0';
    activeName[0] = '\0';
    summaryGallons = 0.0F;
    summaryElapsedMs = 0;
    setMessage("UNAVAILABLE", "Could not start usage log");
    return;
  }
  if (!setConfiguredRelay(settings.relayConfig().charger, true)) {
    stopSessionOutputs();
    pulseStorage.endTag(activeUid);
    activeUid[0] = '\0';
    activeName[0] = '\0';
    summaryGallons = 0.0F;
    summaryElapsedMs = 0;
    setMessage("UNAVAILABLE", "Phone charger control needs service");
    return;
  }
  screenState = ScreenState::ACTIVE;
  screenDirty = true;
  Serial.printf("[SESSION] start uid=%s name=%s allowance=%.2f timeout_min=%lu relay=%u pump=off\n",
                activeUid, activeName, activeAllowance,
                static_cast<unsigned long>(activeTimeoutMs / 60000UL), settings.relayConfig().pump);
}

void pollFlow() {
  const uint32_t sensorTotal = flow.totalPulses();
  const uint32_t delta = sensorTotal - lastSensorTotal;
  lastSensorTotal = sensorTotal;
  if (delta == 0) return;
  if (sessionActive()) {
    pendingPulses += delta;
    sessionPulses += delta;
    screenDirty = true;
    if (gallonsFor(sessionPulses) >= activeAllowance) endSession("LIMIT");
  }
}

void pollRfid() {
  if (!rfidReady || relayTestActive || millis() - lastRfidPollMs < 80) return;
  lastRfidPollMs = millis();
  uint8_t uidBytes[10];
  const int length = rfid.readUid(uidBytes, sizeof(uidBytes));
  if (length <= 0) return;
  const String uid = uidToHex(uidBytes, length);
  const bool repeat = uid == lastScannedUid && millis() - lastScanMs < 2500;
  strlcpy(lastScannedUid, uid.c_str(), sizeof(lastScannedUid));
  lastScanMs = millis();
  rfid.haltTag();
  if (admin.onTagScanned(uid)) { setMessage("WRISTBAND ADDED", "Enrollment complete"); return; }
  if (repeat || calibrationActive) return;
  if (sessionActive()) {
    if (uid == activeUid) return;
    const char* name = members.nameFor(uid.c_str());
    if (name == nullptr || !members.enabledFor(uid.c_str())) {
      // An unknown tag must not end someone else's shower; just show the denial.
      setMessage("NOT AUTHORIZED", name ? "Wristband disabled" : "See a camp admin");
      screenState = ScreenState::ACTIVE;
      screenDirty = true;
      return;
    }
    // Someone forgot to log out: close their shower and log the new member in.
    endSession("HANDOFF");
  }
  startSession(uid);
}

void handleCalibration() {
  if (admin.takeCalibrationStartRequest()) {
    if (relayTestActive) {
      admin.reportCalibration(false, 0, "Finish the relay test first");
    } else if (sessionActive()) {
      admin.reportCalibration(false, 0, "Finish the active shower first");
    } else if (!setConfiguredRelay(settings.relayConfig().pump, true)) {
      stopPump();
      admin.reportCalibration(false, 0, "Pump control failed");
    } else {
      calibrationStartPulses = flow.totalPulses();
      calibrationStartMs = millis();
      calibrationActive = true;
      screenState = ScreenState::CALIBRATION;
      screenDirty = true;
      admin.reportCalibration(true, 0, "Dispensing into known container");
    }
  }
  if (calibrationActive) {
    const uint32_t pulses = flow.totalPulses() - calibrationStartPulses;
    admin.reportCalibration(true, pulses, "Dispensing into known container");
    static uint32_t lastCalibrationDraw = 0;
    if (millis() - lastCalibrationDraw > 250) { screenDirty = true; lastCalibrationDraw = millis(); }
    if (millis() - calibrationStartMs >= Config::MAX_CALIBRATION_MS) {
      stopPump();
      calibrationActive = false;
      admin.reportCalibration(false, pulses, "Safety timeout; value unchanged");
      setMessage("CALIBRATION STOPPED", "10 minute safety timeout");
    }
  }
  float knownGallons = 0.0F;
  if (admin.takeCalibrationStopRequest(knownGallons)) {
    if (!calibrationActive) {
      admin.reportCalibration(false, 0, "Calibration was not running");
      return;
    }
    stopPump();
    const uint32_t pulses = flow.totalPulses() - calibrationStartPulses;
    calibrationActive = false;
    if (pulses == 0 || knownGallons <= 0.0F) {
      admin.reportCalibration(false, pulses, "No pulses captured; value unchanged");
      setMessage("CALIBRATION FAILED", "No flow pulses captured");
      return;
    }
    const float ratio = pulses / knownGallons;
    const bool saved = settings.setCalibration(ratio);
    admin.reportCalibration(false, pulses, saved ? String("Saved ") + String(ratio, 2) + " pulses/gal" : "Could not save calibration");
    setMessage(saved ? "CALIBRATION SAVED" : "CALIBRATION FAILED",
               saved ? String(ratio, 1) + " pulses / gallon" : "Check SD card", 5000);
  }
}

void handleRelayAdmin() {
  if (admin.takeRelayPolicyApplyRequest() && relayReady) {
    shutdownAllRelays();
    if (relayReady) applyAccessoryPolicy();
  }

  uint8_t requestedChannel = 0;
  if (admin.takeRelayTestStartRequest(requestedChannel) && !sessionActive() &&
      !calibrationActive && !relayTestActive && relayReady) {
    shutdownAllRelays();
    if (relayReady && setConfiguredRelay(requestedChannel, true)) {
      relayTestActive = true;
      relayTestChannel = requestedChannel;
      relayTestStartMs = millis();
      Serial.printf("[RELAY] test channel=%u duration_ms=%lu\n", requestedChannel,
                    static_cast<unsigned long>(Config::RELAY_TEST_MS));
    }
  }

  const bool stopRequested = admin.takeRelayTestStopRequest();
  const bool timedOut = relayTestActive &&
                        millis() - relayTestStartMs >= Config::RELAY_TEST_MS;
  if (relayTestActive && (stopRequested || timedOut)) {
    shutdownAllRelays();
    relayTestActive = false;
    relayTestChannel = 0;
    if (relayReady) applyAccessoryPolicy();
    Serial.printf("[RELAY] test stopped reason=%s\n", timedOut ? "timeout" : "admin");
  }
}

// The physical GPIO button and touchscreen button share this lifecycle. The
// first activation starts the water; the next one ends the session (pump off).
void toggleShowerWater(const char* source, const char* endReason) {
  if (calibrationActive) {
    Serial.printf("[%s] ignored during calibration\n", source);
    return;
  }
  if (!sessionActive()) {
    Serial.printf("[%s] ignored; no authorized session\n", source);
    return;
  }

  if (relays.isOn(settings.relayConfig().pump)) {
    // Second activation: the shower is over. endSession() turns the pump off.
    Serial.printf("[%s] finish shower\n", source);
    endSession(endReason);
    return;
  }
  // First activation: start the water.
  if (!setConfiguredRelay(settings.relayConfig().pump, true)) {
    Serial.printf("[%s] pump relay write failed\n", source);
    endSession("RELAY_ERROR");
    return;
  }
  Serial.printf("[%s] pump=on\n", source);
  screenDirty = true;
}

void handlePumpButton() {
  const uint32_t now = millis();
  const bool pressed = digitalRead(Config::PUMP_BUTTON_PIN) == LOW;
  if (pressed != buttonRawPressed) {
    buttonRawPressed = pressed;
    buttonChangedMs = now;
  }
  if (now - buttonChangedMs < Config::BUTTON_DEBOUNCE_MS) return;

  if (pressed != buttonStablePressed) {
    buttonStablePressed = pressed;
    if (pressed) {
      buttonPressedMs = now;
      buttonPressArmed = true;
      buttonStoppedPump = sessionActive() &&
                          relays.isOn(settings.relayConfig().pump);
      strlcpy(buttonPressUid, activeUid, sizeof(buttonPressUid));
      // A possible long press must never leave water running while the user
      // waits for the five-second reboot threshold.
      if (buttonStoppedPump) {
        stopPump();
        screenDirty = true;
      }
      return;
    }

    if (!buttonPressArmed) return;
    buttonPressArmed = false;
    const bool sameSession = sessionActive() &&
                             strcmp(buttonPressUid, activeUid) == 0;
    if (!sameSession) return;
    if (buttonStoppedPump) {
      Serial.println("[BUTTON] finish shower");
      endSession("BUTTON");
    } else {
      toggleShowerWater("BUTTON", "BUTTON");
    }
    return;
  }

  if (buttonStablePressed && buttonPressArmed &&
      now - buttonPressedMs >= Config::BUTTON_REBOOT_HOLD_MS) {
    buttonPressArmed = false;
    rebootController("five-second physical button hold");
  }
}

void handleTouchButton() {
  if ((screenState != ScreenState::ACTIVE &&
       screenState != ScreenState::MUSIC_CHANNEL) || !sessionActive() ||
      calibrationActive || M5.Touch.getCount() == 0) return;

  const auto touch = M5.Touch.getDetail();
  if (!touch.wasClicked() ||
      !stationDisplay.controlButtonContains(touch.x, touch.y)) return;
  toggleShowerWater("TOUCH", "TOUCH");
}

void handleMusicKnob() {
  const uint32_t now = millis();
  if (now - lastMusicKnobReadMs < Config::MUSIC_KNOB_SAMPLE_MS) return;
  lastMusicKnobReadMs = now;

  const uint16_t sample = analogRead(Config::MUSIC_KNOB_PIN);
  // A small low-pass filter removes ADC noise without making the knob sluggish.
  musicKnobRaw = static_cast<uint16_t>(
      (static_cast<uint32_t>(musicKnobRaw) * 7U + sample) / 8U);

  if (admin.takeMusicCalibrationStartRequest()) {
    speakerAudio.stop();
    musicStartPending = false;
    musicKnobMoving = false;
    musicStaticStarted = false;
    musicMotionReferenceRaw = musicKnobRaw;
    musicChannel = 0;
    musicCalibrationActive = true;
    musicCalibrationNextPosition = 0;
    memset(musicCalibrationPositions, 0, sizeof(musicCalibrationPositions));
    musicCalibrationMessage = "Set knob to position 0, then capture";
    Serial.println("[MUSIC] calibration started; waiting for position 0");
  }
  if (admin.takeMusicCalibrationCancelRequest()) {
    musicCalibrationActive = false;
    musicCalibrationNextPosition = 0;
    musicChannel = -1;
    musicKnobMoving = false;
    musicStaticStarted = false;
    musicMotionReferenceRaw = musicKnobRaw;
    musicCalibrationMessage = "Calibration cancelled; previous values retained";
    Serial.println("[MUSIC] calibration cancelled");
  }
  if (admin.takeMusicCalibrationCaptureRequest() && musicCalibrationActive) {
    const uint8_t captured = musicCalibrationNextPosition;
    musicCalibrationPositions[captured] = musicKnobRaw;
    ++musicCalibrationNextPosition;
    Serial.printf("[MUSIC] calibration position=%u raw=%u\n", captured, musicKnobRaw);
    if (musicCalibrationNextPosition >= Config::MUSIC_KNOB_POSITION_COUNT) {
      if (settings.setMusicKnobCalibration(musicCalibrationPositions)) {
        musicCalibrationActive = false;
        musicCalibrationNextPosition = 0;
        musicChannel = -1;
        musicKnobMoving = false;
        musicStaticStarted = false;
        musicMotionReferenceRaw = musicKnobRaw;
        musicCalibrationMessage = "Saved positions 0-9";
        Serial.println("[MUSIC] calibration saved");
      } else {
        musicCalibrationNextPosition = 0;
        musicCalibrationMessage =
            "Invalid spacing or range; return to position 0 and recapture";
        Serial.println("[MUSIC] calibration rejected; points must be ordered and span at least 1000");
      }
    } else {
      musicCalibrationMessage = "Set knob to position " +
                                String(musicCalibrationNextPosition) +
                                ", then capture";
    }
  }

  if (musicCalibrationActive) {
    musicMotionReferenceRaw = musicKnobRaw;
  } else if (!sessionActive()) {
    // The selector is a camper control: while idle it only tracks its physical
    // position for telemetry. It must not start static, music, or lights.
    musicChannel = settings.nearestMusicPosition(musicKnobRaw);
    musicStartPending = false;
    musicKnobMoving = false;
    musicStaticStarted = false;
    musicMotionReferenceRaw = musicKnobRaw;
  } else {
    const uint16_t movement = static_cast<uint16_t>(abs(
        static_cast<int>(musicKnobRaw) -
        static_cast<int>(musicMotionReferenceRaw)));
    if (movement >= Config::MUSIC_KNOB_MOTION_THRESHOLD) {
      musicMotionReferenceRaw = musicKnobRaw;
      lastMusicMovementMs = now;
      if (!musicKnobMoving) {
        musicKnobMoving = true;
        musicStartPending = false;
        musicStaticStarted = speakerAudio.startRadioStatic();
        lastMusicStartAttemptMs = now;
        Serial.printf("[MUSIC] knob moving raw=%u; tuning static=%s\n",
                      musicKnobRaw, musicStaticStarted ? "on" : "waiting");
      }
    }

    if (musicKnobMoving && !musicStaticStarted &&
        now - lastMusicStartAttemptMs >= Config::MUSIC_KNOB_RETRY_MS) {
      lastMusicStartAttemptMs = now;
      musicStaticStarted = speakerAudio.startRadioStatic();
    }

    const bool settled = musicKnobMoving &&
                         now - lastMusicMovementMs >=
                             Config::MUSIC_KNOB_SETTLE_MS;
    if (settled || (!musicKnobMoving && musicChannel < 0)) {
      const int8_t previous = musicChannel;
      uint8_t candidate = settings.nearestMusicPosition(musicKnobRaw);
      if (!settings.musicKnobCalibrated() && musicChannel >= 0) {
        if (musicChannel == 0 && musicKnobRaw < Config::MUSIC_KNOB_ON_RAW)
          candidate = 0;
        if (musicChannel > 0 && musicKnobRaw > Config::MUSIC_KNOB_OFF_RAW)
          candidate = 1;
      } else if (settings.musicKnobCalibrated() && musicChannel >= 0 &&
                 candidate != static_cast<uint8_t>(musicChannel)) {
        const uint16_t currentDistance = static_cast<uint16_t>(abs(
            static_cast<int>(musicKnobRaw) -
            static_cast<int>(settings.musicKnobPosition(musicChannel))));
        const uint16_t candidateDistance = static_cast<uint16_t>(abs(
            static_cast<int>(musicKnobRaw) -
            static_cast<int>(settings.musicKnobPosition(candidate))));
        if (candidateDistance + Config::MUSIC_KNOB_CHANNEL_HYSTERESIS >=
            currentDistance) {
          candidate = static_cast<uint8_t>(musicChannel);
        }
      }

      musicKnobMoving = false;
      musicStaticStarted = false;
      musicMotionReferenceRaw = musicKnobRaw;
      musicChannel = candidate;
      musicStartPending = candidate > 0;
      lastMusicStartAttemptMs = now - Config::MUSIC_KNOB_RETRY_MS;
      if (candidate != static_cast<uint8_t>(previous)) {
        musicChannelUntilMs = now + Config::MUSIC_CHANNEL_DISPLAY_MS;
        screenState = ScreenState::MUSIC_CHANNEL;
        screenDirty = true;
      }
      if (candidate == 0) {
        speakerAudio.stop();
        Serial.printf("[MUSIC] knob settled raw=%u channel %d -> quiet\n",
                      musicKnobRaw, previous);
      } else {
        Serial.printf("[MUSIC] knob settled raw=%u channel %d -> %u (%s)\n",
                      musicKnobRaw, previous, candidate,
                      Config::MUSIC_CHANNEL_NAMES[candidate]);
      }
    }

    if (!musicKnobMoving && musicStartPending &&
        now - lastMusicStartAttemptMs >= Config::MUSIC_KNOB_RETRY_MS) {
      lastMusicStartAttemptMs = now;
      if (speakerAudio.playChannel(static_cast<uint8_t>(musicChannel))) {
        musicStartPending = false;
        Serial.printf("[MUSIC] channel=%d song started\n", musicChannel);
      } else {
        Serial.println("[MUSIC] waiting for speaker and channel file");
      }
    }
  }

  admin.reportMusicKnob(musicKnobRaw, musicChannel, musicCalibrationActive,
                        musicCalibrationNextPosition, musicCalibrationMessage);

  if (now - lastMusicKnobLogMs >= 1000) {
    lastMusicKnobLogMs = now;
    Serial.printf("[MUSIC] knob=%u/4095 channel=%d moving=%s calibrated=%s\n",
                  musicKnobRaw, musicChannel, musicKnobMoving ? "yes" : "no",
                  settings.musicKnobCalibrated() ? "yes" : "no");
  }
}

void reportAdminState() {
  admin.reportHardware(hubReady, relayReady, rfidReady);
  admin.reportOtaBootPending(otaPendingVerification);
  admin.reportRelays(relays.state(), relayTestActive, relayTestChannel);
  admin.reportSession(activeName, sessionActive() ? gallonsFor(sessionPulses) : 0.0F,
                      sessionActive() ? activeAllowance : 0.0F,
                      relayReady && relays.isOn(settings.relayConfig().pump),
                      doorDisplayState());
}

void serviceReliability() {
  const uint32_t now = millis();

  // The radio (soft-AP + ESP-NOW) and admin server retry at runtime instead of
  // staying dead until a reboot.
  static uint32_t lastAdminRetryMs = 0;
  if ((!campNet.ready() || !admin.started()) &&
      now - lastAdminRetryMs >= Config::ADMIN_RETRY_INTERVAL_MS) {
    lastAdminRetryMs = now;
    if (!campNet.ready()) {
      Serial.printf("[NET] retry %s\n", campNet.begin() ? "recovered" : "failed");
    }
    if (campNet.ready() && !admin.started()) {
      if (admin.begin()) {
        Serial.printf("[WEB] admin server recovered at http://%s/\n",
                      admin.address().c_str());
      } else {
        Serial.println("[WEB] admin server retry failed");
      }
    }
  }

  reportAdminState();
  // A remote END SESSION over CampNet can only stop water, never start it.
  if (admin.takeEndSessionRequest() && sessionActive()) endSession("REMOTE");
  if (admin.takeSpeakerSearchRequest() && Config::HAS_MUSIC) speakerAudio.requestDiscovery();
  if (admin.takeRebootRequest()) {
    rebootController("admin page");
  }

  static uint32_t lastHealthLogMs = 0;
  if (now - lastHealthLogMs >= Config::HEALTH_LOG_INTERVAL_MS) {
    lastHealthLogMs = now;
    Serial.printf("[HEALTH] uptime=%lus heap=%u min_heap=%u max_alloc=%u psram=%u wifi_clients=%u underruns=%lu net_peers=%u net_rx=%lu net_tx=%lu net_txfail=%lu net_rxdrop=%lu\n",
                  static_cast<unsigned long>(now / 1000), ESP.getFreeHeap(),
                  ESP.getMinFreeHeap(), ESP.getMaxAllocHeap(), ESP.getFreePsram(),
                  WiFi.softAPgetStationNum(),
                  static_cast<unsigned long>(speakerAudio.bufferUnderruns()),
                  static_cast<unsigned>(campNet.peerCount()),
                  static_cast<unsigned long>(campNet.rxPackets()),
                  static_cast<unsigned long>(campNet.txPackets()),
                  static_cast<unsigned long>(campNet.txFailures()),
                  static_cast<unsigned long>(campNet.rxDropped()));
  }
}

void printStatus() {
  Serial.printf("[STATION] id=%u role=%s name=%s ssid=%s channel=%u peers=%u members=%u/v%lu limits=v%lu\n",
                Config::STATION_ID_VALUE, CampNet::roleName(Config::STATION_ROLE_VALUE),
                Config::STATION_NAME, Config::WIFI_AP_NAME, CampNet::CHANNEL,
                static_cast<unsigned>(campNet.peerCount()), static_cast<unsigned>(members.count()),
                static_cast<unsigned long>(members.version()),
                static_cast<unsigned long>(settings.limitsVersion()));
  Serial.printf("[STATE] state=%u uid=%s pulses=%lu gallons=%.3f limit=%.2f relay=0x%02X sd=%s hub=%s@0x%02X relay_ch=%d rfid=%s rfid_ch=%d calibration=%.2f\n",
                static_cast<unsigned>(screenState), sessionActive() ? activeUid : "NONE",
                static_cast<unsigned long>(sessionPulses), gallonsFor(sessionPulses),
                activeAllowance, relays.state(), pulseStorage.healthy() ? "ok" : "fail",
                hubReady ? "ok" : "fail", hubAddress, relayChannel,
                rfidReady ? "ok" : "fail", rfidChannel, settings.pulsesPerGallon());
  const SettingsStore::RelayConfig& relayConfig = settings.relayConfig();
  Serial.printf("[RELAY] pump=%u charger=%u accessory=%u accessory_enabled=%s state=0x%02X test=%u\n",
                relayConfig.pump, relayConfig.charger, relayConfig.accessory,
                relayConfig.accessoryEnabled ? "yes" : "no", relays.state(),
                relayTestActive ? relayTestChannel : 0);
  Serial.printf("[MUSIC] knob=%u/4095 channel=%d calibrated=%s speaker=%s speaker_volume=%u%% playback=%s pcm_bass=%u pcm_mid=%u pcm_treble=%u pcm_volume=%u\n",
                musicKnobRaw, musicChannel,
                settings.musicKnobCalibrated() ? "yes" : "no",
                speakerAudio.connectionLabel(),
                speakerAudio.speakerVolumePercent(), speakerAudio.playbackLabel(),
                speakerAudio.bassLevel(), speakerAudio.midLevel(),
                speakerAudio.trebleLevel(), speakerAudio.volumeLevel());
}

void processSerialCommand(String command) {
  command.trim(); command.toLowerCase();
  if (command == "off") { if (sessionActive()) endSession("SERIAL"); else { stopSessionOutputs(); setMessage("WATER OFF", "Pump and charger stopped"); } }
  else if (command == "end") endSession("SERIAL");
  else if (command == "status") printStatus();
  else if (command == "tone") Serial.println(speakerAudio.playTestTone() ? "[AUDIO] tone requested" : "[AUDIO] speaker not connected");
  else if (command == "play") Serial.println(speakerAudio.playSong() ? "[AUDIO] song requested" : "[AUDIO] speaker/file unavailable");
  else if (command.length() == 5 && command.startsWith("play") &&
           command[4] >= '1' && command[4] <= '9') {
    const uint8_t channel = static_cast<uint8_t>(command[4] - '0');
    Serial.printf("[AUDIO] channel %u %s\n", channel,
                  speakerAudio.playChannel(channel) ? "requested" : "unavailable");
  }
  else if (command == "stop") speakerAudio.stop();
  else if (!command.isEmpty()) Serial.println("[HELP] commands: off end status tone play play1..play9 stop");
}

void handleSerial() {
  while (Serial.available()) {
    const char value = static_cast<char>(Serial.read());
    if (value == '\n' || value == '\r') { if (!serialCommand.isEmpty()) { processSerialCommand(serialCommand); serialCommand = ""; } }
    else if (serialCommand.length() < 32) serialCommand += value;
  }
}

const char* resetReasonName(esp_reset_reason_t reason) {
  switch (reason) {
    case ESP_RST_POWERON: return "POWERON";
    case ESP_RST_EXT: return "EXT";
    case ESP_RST_SW: return "SW";
    case ESP_RST_PANIC: return "PANIC";
    case ESP_RST_INT_WDT: return "INT_WDT";
    case ESP_RST_TASK_WDT: return "TASK_WDT";
    case ESP_RST_WDT: return "WDT";
    case ESP_RST_DEEPSLEEP: return "DEEPSLEEP";
    case ESP_RST_BROWNOUT: return "BROWNOUT";
    case ESP_RST_SDIO: return "SDIO";
    default: return "UNKNOWN";
  }
}

// One CSV row per boot: why the chip reset and whether the relay module was
// still driving the pump when we came up -- the forensic trail for crashes
// that never reach a serial monitor.
void appendBootLog(bool sdReady) {
  const char* reason = resetReasonName(esp_reset_reason());
  char stateCell[8];
  if (bootRelayStateKnown) {
    snprintf(stateCell, sizeof(stateCell), "0x%02X", bootRelayState);
  } else {
    strlcpy(stateCell, "NA", sizeof(stateCell));
  }
  const uint8_t pump = settings.relayConfig().pump;
  const bool pumpValid = bootRelayStateKnown && pump >= 1 && pump <= 4;
  const char* pumpCell = !pumpValid ? "NA"
      : (bootRelayState & (1U << (4U - pump))) != 0 ? "1" : "0";
  Serial.printf("[FORENSICS] reset=%s relay_at_boot=%s pump_latched=%s\n",
                reason, stateCell, pumpCell);
  if (!sdReady) return;
  if (!SD.exists(Config::BOOT_LOG_PATH)) {
    File file = SD.open(Config::BOOT_LOG_PATH, FILE_WRITE);
    if (!file) return;
    StorageWrite::line(file,
        "uptime_ms,reset_reason,relay_state_at_boot,pump_was_latched,hub,relay,rfid,sd");
    file.flush();
    file.close();
  }
  File file = SD.open(Config::BOOT_LOG_PATH, FILE_APPEND);
  if (!file) return;
  StorageWrite::formatted(file, "%lu,%s,%s,%s,%s,%s,%s,%s\n",
                          static_cast<unsigned long>(millis()), reason, stateCell,
                          pumpCell, hubReady ? "ok" : "fail",
                          relayReady ? "ok" : "fail", rfidReady ? "ok" : "fail",
                          sdReady ? "ok" : "fail");
  file.flush();
  file.close();
}
}

void setup() {
  Serial.begin(115200);
  delay(200);
  auto config = M5.config();
  M5.begin(config);
  // Start supervision before storage, I2C, radio, or Bluetooth setup so a bad
  // OTA image that wedges during setup is reset and the bootloader can revert.
  esp_task_wdt_init(Config::WDT_TIMEOUT_S, true);
  esp_task_wdt_add(nullptr);
  const esp_partition_t* runningPartition = esp_ota_get_running_partition();
  esp_ota_img_states_t otaState;
  otaPendingVerification = runningPartition != nullptr &&
                           esp_ota_get_state_partition(runningPartition, &otaState) == ESP_OK &&
                           otaState == ESP_OTA_IMG_PENDING_VERIFY;
  if (otaPendingVerification) Serial.println("[OTA] new image pending boot health verification");
  // Tough's AXP192 gates 5 V to the external HY2.0 ports. Keep Port A powered
  // explicitly before probing the PaHUB rather than relying on library defaults.
  M5.Power.setExtOutput(true);
  delay(150);

  // A watchdog reset does not power-cycle the external 4Relay module. Force it
  // off before display, SD replay, LEDs, radio or Bluetooth can delay boot.
  // A crashed transfer can leave a slave holding SDA low, which would block
  // the relay-off below; clock the bus clear before the first transaction.
  i2cBusRecover(Wire, Config::I2C_SDA, Config::I2C_SCL, Config::I2C_FREQUENCY);
  discoverI2cDevices();
  bootRelayStateKnown = relays.preClearStateKnown();
  bootRelayState = relays.preClearState();
  esp_task_wdt_reset();

  M5.Display.setRotation(1);
  stationDisplay.begin();
  pinMode(Config::PUMP_BUTTON_PIN, INPUT_PULLUP);
  buttonRawPressed = digitalRead(Config::PUMP_BUTTON_PIN) == LOW;
  buttonStablePressed = buttonRawPressed;
  buttonChangedMs = millis();
  if (Config::HAS_MUSIC) {
    pinMode(Config::MUSIC_KNOB_PIN, INPUT);
    analogReadResolution(12);
    analogSetPinAttenuation(Config::MUSIC_KNOB_PIN, ADC_11db);
    uint32_t initialKnobTotal = 0;
    for (uint8_t i = 0; i < 16; ++i) initialKnobTotal += analogRead(Config::MUSIC_KNOB_PIN);
    musicKnobRaw = static_cast<uint16_t>(initialKnobTotal / 16U);
    musicMotionReferenceRaw = musicKnobRaw;
  }
  if (Config::HAS_LED_STRIP) lightShow.begin();
  drawScreen();

  flow.begin(Config::FLOW_PIN);
  lastSensorTotal = flow.totalPulses();
  const bool sdReady = pulseStorage.begin();
  esp_task_wdt_reset();
  const bool membersReady = sdReady && members.begin();
  esp_task_wdt_reset();
  const bool settingsReady = sdReady && settings.begin();
  esp_task_wdt_reset();
  const bool sessionsReady = sdReady && sessions.begin();
  esp_task_wdt_reset();
  const bool ledgerReady = sdReady && ledger.begin();
  esp_task_wdt_reset();

  // Relay discovery used safe defaults above. Now that the saved mapping is
  // available, begin from all-off again and restore only configured accessory
  // power. Pump and charger remain off.
  shutdownAllRelays();
  if (relayReady && !applyAccessoryPolicy()) relayReady = false;
  appendBootLog(sdReady);
  const bool netReady = campNet.begin();
  const bool adminReady = netReady && admin.begin();
  esp_task_wdt_reset();
  bool audioReady = false;
  if (Config::HAS_MUSIC) {
    speakerAudio.setSpeakerVolumePercent(settings.speakerVolumePercent());
    audioReady = speakerAudio.begin();
    esp_task_wdt_reset();
  }

  Serial.printf("[BOOT] station=%u role=%s board=%u ext5v=%s sd=%s members=%s settings=%s sessions=%s ledger=%s hub=%s relay=%s rfid=%s net=%s admin=%s reset=%s\n",
                Config::STATION_ID_VALUE, CampNet::roleName(Config::STATION_ROLE_VALUE),
                static_cast<unsigned>(M5.getBoard()), M5.Power.getExtOutput()?"on":"off",
                sdReady?"ok":"fail", membersReady?"ok":"fail", settingsReady?"ok":"fail",
                sessionsReady?"ok":"fail", ledgerReady?"ok":"fail", hubReady?"ok":"fail",
                relayReady?"ok":"fail", rfidReady?"ok":"fail", netReady?"ok":"fail",
                adminReady?"ok":"fail", resetReasonName(esp_reset_reason()));
  Serial.printf("[WEB] ssid=%s address=http://%s/ page_password=%s\n", Config::WIFI_AP_NAME,
                admin.address().c_str(), Config::ADMIN_PAGE_PASSWORD ? "on" : "off");
  Serial.printf("[NET] channel=%u door_sign=%s members_version=%lu limits_version=%lu\n",
                CampNet::CHANNEL, Config::HAS_DOOR_SIGN ? "yes" : "no",
                static_cast<unsigned long>(members.version()),
                static_cast<unsigned long>(settings.limitsVersion()));
  if (Config::HAS_MUSIC) {
    Serial.printf("[AUDIO] source=%s file=%s path=%s\n", audioReady ? "ready" : "failed",
                  speakerAudio.fileAvailable() ? "ready" : "missing", Config::AUDIO_PATH);
    Serial.printf("[MUSIC] knob_pin=%u raw=%u on=%u off=%u\n", Config::MUSIC_KNOB_PIN,
                  musicKnobRaw, Config::MUSIC_KNOB_ON_RAW, Config::MUSIC_KNOB_OFF_RAW);
  } else {
    Serial.println("[AUDIO] disabled for this station role");
  }
  Serial.printf("[I2C] pahub_0x%02X=%s relay_0x26=ch%d rfid_0x28=ch%d\n",
                hubAddress, hubReady?"yes":"no", relayChannel, rfidChannel);
  const SettingsStore::RelayConfig& relayConfig = settings.relayConfig();
  Serial.printf("[RELAY] pump=%u charger=%u accessory=%u accessory_enabled=%s state=0x%02X\n",
                relayConfig.pump, relayConfig.charger, relayConfig.accessory,
                relayConfig.accessoryEnabled ? "yes" : "no", relays.state());
  Serial.println("[HELP] commands: off end status tone play play1..play9 stop");
  screenDirty = true;

  // The loop continues feeding the watchdog initialized before hardware setup.
}

void loop() {
  esp_task_wdt_reset();
  M5.update();
  // Refresh lifecycle truth before WebServer or remote COMMAND handlers can
  // accept an idle-only relay action.
  reportAdminState();
  admin.handle();
  serviceOtaBootVerification();
  if (serviceOtaLifecycle()) return;
  if (Config::HAS_MUSIC) speakerAudio.handle();
  if (Config::HAS_LED_STRIP) lightShow.handle(speakerAudio, sessionActive());
  serviceCampNet();
  serviceI2cRecovery();
  serviceRelayEmergency();
  handleRelayAdmin();
  serviceReliability();
  handlePumpButton();
  handleTouchButton();
  if (Config::HAS_MUSIC) handleMusicKnob();
  handleSerial();
  pollFlow();
  pollRfid();
  handleCalibration();
  if (sessionActive() && pendingPulses > 0 && millis() - lastLogMs >= Config::LOG_INTERVAL_MS) {
    if (!flushPulses()) endSession("SD_ERROR");
    lastLogMs = millis();
  }
  if (sessionActive() && millis() - sessionStartMs >= activeTimeoutMs) {
    endSession("TIMEOUT");
  }
  if (screenState == ScreenState::MUSIC_CHANNEL &&
      static_cast<int32_t>(millis() - musicChannelUntilMs) >= 0) {
    screenState = sessionActive() ? ScreenState::ACTIVE : ScreenState::IDLE;
    screenDirty = true;
  }
  if (screenState == ScreenState::MESSAGE && static_cast<int32_t>(millis() - messageUntilMs) >= 0) {
    summaryGallons = 0.0F;
    summaryElapsedMs = 0;
    summaryReady = false;
    screenState = sessionActive() ? ScreenState::ACTIVE : ScreenState::IDLE;
    screenDirty = true;
  }
  static uint32_t lastActiveScreenTickMs = 0;
  if (screenState == ScreenState::ACTIVE &&
      relays.isOn(settings.relayConfig().pump) &&
      millis() - lastActiveScreenTickMs >= 1000) {
    lastActiveScreenTickMs = millis();
    screenDirty = true;
  }
  static uint32_t lastDrawMs = 0;
  if (screenDirty && millis() - lastDrawMs >= 250) { drawScreen(); lastDrawMs = millis(); }
  delay(5);
}
