EricRollei/Burningman_Camp_Shower_Control/firmware/shower-controller/include/BigTopDisplayFont.h

#pragma once

// Display-only uppercase subset generated from Rye Regular 18 pt.
// Copyright (c) 2011 Sorkin Type Co. Licensed under the SIL Open Font
// License 1.1; see THIRD_PARTY_NOTICES.md. The converted derivative uses a
// different name because "Rye" is a Reserved Font Name under that license.

const uint8_t BigTopDisplay18pt7bBitmaps[] PROGMEM = {
  0x00, 0x0F, 0x07, 0xFF, 0xFF, 0xF9, 0xFD, 0x1F, 0xC1, 0xFC, 0x1F, 0x81,
  0xB8, 0x1B, 0x81, 0xB8, 0x0B, 0x80, 0xB8, 0x0B, 0x80, 0xB8, 0x0B, 0x80,
  0xF0, 0x0F, 0x00, 0xF0, 0x07, 0x00, 0x70, 0x06, 0x00, 0x00, 0x00, 0x00,
  0x00, 0x07, 0x00, 0xB8, 0x17, 0xC3, 0x7E, 0x0B, 0x80, 0x70, 0x3C, 0x3C,
  0x7E, 0x7E, 0xDE, 0xDF, 0x5F, 0x5F, 0x5E, 0x7E, 0x3C, 0x3C, 0x3C, 0x3C,
  0x3C, 0x3C, 0x18, 0x1C, 0x18, 0x18, 0x18, 0x18, 0x18, 0x18, 0x18, 0x18,
  0x01, 0x81, 0x80, 0x18, 0x38, 0x01, 0xC3, 0x80, 0x18, 0x38, 0x03, 0x83,
  0x80, 0x38, 0x38, 0x03, 0x83, 0x00, 0x38, 0x70, 0x03, 0x87, 0x00, 0x30,
  0x70, 0x1F, 0xFF, 0xF7, 0xFF, 0xFF, 0x7F, 0xFF, 0xE0, 0x70, 0xE0, 0x07,
  0x0E, 0x00, 0xE0, 0xE0, 0xFF, 0xFF, 0xEF, 0xFF, 0xFE, 0x0E, 0x1C, 0x00,
  0xE1, 0xC0, 0x0C, 0x1C, 0x01, 0xC1, 0xC0, 0x1C, 0x1C, 0x01, 0xC1, 0x80,
  0x1C, 0x38, 0x01, 0xC3, 0x80, 0x18, 0x38, 0x01, 0x81, 0x80, 0x02, 0x20,
  0x00, 0xCC, 0x00, 0x33, 0x00, 0x0C, 0xC0, 0x03, 0x30, 0x00, 0xCC, 0x40,
  0x3F, 0x18, 0x3F, 0xC6, 0x3F, 0xBF, 0x8F, 0x81, 0xE7, 0xC0, 0x79, 0xF0,
  0x0E, 0xDE, 0x03, 0xB7, 0x80, 0xC6, 0xF8, 0x31, 0xBF, 0x20, 0x77, 0xF8,
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
  {  2227,  22,  29,  23,    1,  -27 },   // 0x46 'F'
  {  2307,  24,  28,  25,    1,  -26 },   // 0x47 'G'
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

const GFXfont BigTopDisplay18pt7b PROGMEM = {
  (uint8_t  *)BigTopDisplay18pt7bBitmaps,
  (GFXglyph *)BigTopDisplay18pt7bGlyphs,
  0x20, 0x5A, 44 };

// Approx. 4515 bytes
