EricRollei/Burningman_Camp_Shower_Control/firmware/shower-controller/src/PulseStorage.cpp

#include "PulseStorage.h"

#include <SD.h>
#include <SPI.h>

#include "Config.h"
#include "PsramAlloc.h"
#include "StorageWrite.h"

bool PulseStorage::begin() {
  if (totals_ == nullptr) totals_ = psramArray<TagTotal>(MAX_TAGS);
  if (totals_ == nullptr) {
    healthy_ = false;
    return false;
  }
  tagCount_ = 0;
  SPI.begin(Config::SD_SCK, Config::SD_MISO, Config::SD_MOSI, Config::SD_CS);
  healthy_ = SD.begin(Config::SD_CS, SPI, Config::SD_FREQUENCY);
  if (!healthy_ || SD.cardType() == CARD_NONE) {
    healthy_ = false;
    return false;
  }

  cardSizeMB_ = SD.cardSize() / (1024ULL * 1024ULL);
  if (!SD.exists(Config::PULSE_SNAPSHOT_PATH) && SD.exists("/PULSETOT.BAK")) {
    SD.rename("/PULSETOT.BAK", Config::PULSE_SNAPSHOT_PATH);
  }
  if (!SD.exists(Config::LOG_PATH)) {
    File file = SD.open(Config::LOG_PATH, FILE_WRITE);
    if (!file) {
      healthy_ = false;
      return false;
    }
    const bool written = StorageWrite::line(
        file, "uptime_ms,uid,delta_pulses,tag_total_pulses,event");
    file.flush();
    file.close();
    if (!written) {
      healthy_ = false;
      return false;
    }
  }

  restoreTotals();
  return healthy_;
}

bool PulseStorage::selectTag(const char* uid) {
  const int index = ensureTag(uid);
  return index >= 0 && append(uid, 0, totals_[index].pulses, "SELECT");
}

bool PulseStorage::recordPulses(const char* uid, uint32_t delta) {
  if (delta == 0) return true;
  const int index = ensureTag(uid);
  if (index < 0) return false;
  const uint64_t nextTotal = totals_[index].pulses + delta;
  if (!append(uid, delta, nextTotal, "PULSES")) return false;
  totals_[index].pulses = nextTotal;
  return true;
}

bool PulseStorage::endTag(const char* uid) {
  const int index = findTag(uid);
  const bool logged = index >= 0 && append(uid, 0, totals_[index].pulses, "END");
  // Sessions end rarely, so this is a cheap moment to compact the totals into
  // a snapshot; the next boot then replays only the log tail.
  return logged && writeSnapshot();
}

uint64_t PulseStorage::totalFor(const char* uid) const {
  const int index = findTag(uid);
  return index >= 0 ? totals_[index].pulses : 0;
}

int PulseStorage::findTag(const char* uid) const {
  for (size_t i = 0; i < tagCount_; ++i) {
    if (strcmp(totals_[i].uid, uid) == 0) return static_cast<int>(i);
  }
  return -1;
}

int PulseStorage::ensureTag(const char* uid) {
  const int existing = findTag(uid);
  if (existing >= 0) return existing;
  if (tagCount_ >= MAX_TAGS || strlen(uid) >= UID_SIZE) return -1;

  strlcpy(totals_[tagCount_].uid, uid, UID_SIZE);
  totals_[tagCount_].pulses = 0;
  return static_cast<int>(tagCount_++);
}

bool PulseStorage::append(const char* uid, uint32_t delta, uint64_t total,
                          const char* event) {
  if (!healthy_) return false;
  File file = SD.open(Config::LOG_PATH, FILE_APPEND);
  if (!file) {
    healthy_ = false;
    return false;
  }

  const bool written = StorageWrite::formatted(
      file, "%lu,%s,%lu,%llu,%s\n", static_cast<unsigned long>(millis()), uid,
      static_cast<unsigned long>(delta), static_cast<unsigned long long>(total), event);
  file.flush();
  file.close();
  if (!written) healthy_ = false;
  return written;
}

void PulseStorage::restoreTotals() {
  uint64_t replayOffset = 0;
  if (!loadSnapshot(replayOffset)) {
    tagCount_ = 0;
    replayOffset = 0;
  }
  replayLog(replayOffset);
}

bool PulseStorage::loadSnapshot(uint64_t& replayOffset) {
  File file = SD.open(Config::PULSE_SNAPSHOT_PATH, FILE_READ);
  if (!file) return false;
  bool haveOffset = false;
  bool haveExpectedCount = false;
  size_t expectedCount = 0;
  while (file.available()) {
    String line = file.readStringUntil('\n');
    line.trim();
    if (line.startsWith("offset,")) {
      replayOffset = strtoull(line.c_str() + 7, nullptr, 10);
      haveOffset = true;
      continue;
    }
    if (line.startsWith("count,")) {
      expectedCount = static_cast<size_t>(strtoul(line.c_str() + 6, nullptr, 10));
      haveExpectedCount = true;
      continue;
    }
    char uid[UID_SIZE] = {0};
    unsigned long long total = 0;
    if (sscanf(line.c_str(), "%20[^,],%llu", uid, &total) != 2) continue;
    const int index = ensureTag(uid);
    if (index >= 0) totals_[index].pulses = total;
  }
  file.close();
  return haveOffset && (!haveExpectedCount || tagCount_ == expectedCount);
}

bool PulseStorage::writeSnapshot() {
  if (!healthy_) return false;
  uint64_t logSize = 0;
  {
    File log = SD.open(Config::LOG_PATH, FILE_READ);
    if (!log) {
      healthy_ = false;
      return false;
    }
    logSize = log.size();
    log.close();
  }
  constexpr char tempPath[] = "/PULSETOT.TMP";
  constexpr char backupPath[] = "/PULSETOT.BAK";
  SD.remove(tempPath);
  File file = SD.open(tempPath, FILE_WRITE);
  if (!file) {
    healthy_ = false;
    return false;
  }
  bool written = StorageWrite::formatted(
      file, "offset,%llu\n", static_cast<unsigned long long>(logSize));
  written = written && StorageWrite::formatted(file, "count,%u\n",
                                                static_cast<unsigned>(tagCount_));
  for (size_t i = 0; i < tagCount_; ++i) {
    written = written && StorageWrite::formatted(
                             file, "%s,%llu\n", totals_[i].uid,
                             static_cast<unsigned long long>(totals_[i].pulses));
  }
  file.flush();
  file.close();
  if (!written) {
    SD.remove(tempPath);
    healthy_ = false;
    return false;
  }
  SD.remove(backupPath);
  if (SD.exists(Config::PULSE_SNAPSHOT_PATH) &&
      !SD.rename(Config::PULSE_SNAPSHOT_PATH, backupPath)) {
    SD.remove(tempPath);
    healthy_ = false;
    return false;
  }
  if (!SD.rename(tempPath, Config::PULSE_SNAPSHOT_PATH)) {
    if (SD.exists(backupPath)) SD.rename(backupPath, Config::PULSE_SNAPSHOT_PATH);
    SD.remove(tempPath);
    healthy_ = false;
    return false;
  }
  SD.remove(backupPath);
  return true;
}

void PulseStorage::replayLog(uint64_t fromOffset) {
  File file = SD.open(Config::LOG_PATH, FILE_READ);
  if (!file) {
    healthy_ = false;
    return;
  }
  if (fromOffset > file.size() || (fromOffset > 0 && !file.seek(fromOffset))) {
    // Snapshot points past the log (log was replaced): fall back to a full
    // replay with fresh totals.
    tagCount_ = 0;
    file.seek(0);
    fromOffset = 0;
  }

  bool firstLine = fromOffset == 0;  // skip the CSV header only from the top
  while (file.available()) {
    String line = file.readStringUntil('\n');
    line.trim();
    if (firstLine) {
      firstLine = false;
      continue;
    }

    unsigned long uptime = 0;
    char uid[UID_SIZE] = {0};
    unsigned long delta = 0;
    unsigned long long total = 0;
    char event[12] = {0};
    const int fields = sscanf(line.c_str(), "%lu,%20[^,],%lu,%llu,%11s",
                              &uptime, uid, &delta, &total, event);
    if (fields != 5) continue;

    const int index = ensureTag(uid);
    if (index >= 0) totals_[index].pulses = total;
  }
  file.close();
}
