EricRollei/Burningman_Camp_Shower_Control/firmware/shower-controller/include/PurpleRainTiming.h

#pragma once

#include <Arduino.h>

namespace PurpleRainTiming {

// Beat locations extracted from the installed 4:05 CH1.PCM with a weighted
// spectral-flux onset tracker and dynamic-programming beat path. Units are
// 10 ms, which keeps the complete non-drifting map under 1 KB in flash.
constexpr uint16_t BEATS_10MS[] = {
    17, 70, 123, 175, 228, 281, 332, 384, 435, 486, 539, 592, 643, 695, 747, 795,
    848, 900, 951, 1001, 1051, 1102, 1154, 1204, 1256, 1307, 1358, 1408, 1461,
    1515, 1569, 1616, 1664, 1717, 1773, 1826, 1876, 1927, 1977, 2027, 2077,
    2128, 2180, 2230, 2281, 2332, 2385, 2436, 2488, 2539, 2594, 2644, 2696,
    2746, 2796, 2847, 2896, 2945, 2999, 3049, 3102, 3156, 3209, 3260, 3311,
    3365, 3418, 3469, 3520, 3570, 3621, 3673, 3723, 3773, 3825, 3878, 3931,
    3983, 4034, 4087, 4139, 4194, 4245, 4293, 4346, 4398, 4452, 4505, 4557,
    4610, 4663, 4715, 4769, 4820, 4875, 4924, 4977, 5028, 5079, 5129, 5184,
    5237, 5293, 5344, 5396, 5450, 5502, 5553, 5604, 5658, 5711, 5763, 5815,
    5867, 5921, 5972, 6027, 6080, 6135, 6188, 6238, 6290, 6341, 6392, 6445,
    6498, 6552, 6603, 6655, 6707, 6762, 6814, 6868, 6923, 6975, 7026, 7077,
    7129, 7182, 7233, 7284, 7336, 7390, 7441, 7494, 7545, 7598, 7649, 7700,
    7753, 7809, 7856, 7911, 7963, 8017, 8068, 8122, 8176, 8230, 8280, 8335,
    8386, 8438, 8492, 8537, 8583, 8633, 8682, 8737, 8791, 8846, 8897, 8949,
    9000, 9055, 9107, 9159, 9214, 9266, 9317, 9369, 9420, 9474, 9525, 9576,
    9628, 9683, 9734, 9785, 9836, 9885, 9935, 9985, 10036, 10088, 10137,
    10188, 10239, 10291, 10342, 10394, 10447, 10500, 10550, 10601, 10652,
    10701, 10752, 10801, 10852, 10904, 10956, 11006, 11059, 11110, 11161,
    11214, 11269, 11323, 11372, 11424, 11475, 11529, 11581, 11633, 11685,
    11740, 11790, 11843, 11893, 11946, 12000, 12055, 12106, 12157, 12208,
    12261, 12314, 12369, 12422, 12474, 12526, 12578, 12630, 12683, 12736,
    12790, 12842, 12896, 12949, 13002, 13054, 13107, 13161, 13214, 13267,
    13320, 13370, 13423, 13475, 13528, 13581, 13635, 13687, 13739, 13793,
    13847, 13901, 13952, 14007, 14061, 14113, 14166, 14218, 14270, 14321,
    14373, 14425, 14479, 14532, 14584, 14636, 14688, 14741, 14795, 14847,
    14900, 14951, 15004, 15057, 15109, 15163, 15217, 15269, 15323, 15374,
    15426, 15470, 15517, 15563, 15613, 15663, 15711, 15759, 15802, 15848,
    15894, 15944, 15995, 16048, 16101, 16155, 16206, 16260, 16316, 16368,
    16421, 16472, 16524, 16579, 16632, 16685, 16739, 16793, 16845, 16898,
    16952, 17003, 17057, 17108, 17162, 17215, 17269, 17320, 17372, 17424,
    17475, 17530, 17588, 17643, 17694, 17747, 17795, 17848, 17900, 17954,
    18005, 18057, 18109, 18163, 18214, 18267, 18317, 18372, 18427, 18481,
    18533, 18588, 18644, 18697, 18748, 18801, 18852, 18907, 18958, 19010,
    19061, 19111, 19168, 19221, 19274, 19327, 19379, 19434, 19487, 19540,
    19591, 19643, 19694, 19747, 19800, 19851, 19903, 19958, 20011, 20064,
    20118, 20172, 20226, 20280, 20337, 20391, 20445, 20499, 20552, 20604,
    20654, 20705, 20757, 20811, 20863, 20917, 20968, 21020, 21074, 21129,
    21186, 21237, 21290, 21344, 21396, 21449, 21502, 21556, 21612, 21665,
    21718, 21768, 21819, 21873, 21925, 21978, 22035, 22086, 22136, 22186,
    22238, 22290, 22341, 22393, 22443, 22498, 22549, 22601, 22650, 22702,
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
};

constexpr uint16_t BEAT_COUNT =
    sizeof(BEATS_10MS) / sizeof(BEATS_10MS[0]);

}  // namespace PurpleRainTiming
