EricRollei/Burningman_Camp_Shower_Control/(commit log)

2026-07-31 Add documentation framework: index README, topic docs, placeholder drawings
2026-07-31 Populate BOM from full Amazon wishlist; switch to propane heater and 30Ah battery
2026-08-01 Add M5Stack control parts, 1in suction hose, SAE pigtail, and 9in supply hoses to BOM
2026-08-08 Add Main Circuit Wiring section to README with power diagram and drawio source
2026-08-09 Add Control Circuits section to README with control diagram and drawio source
2026-08-10 Swap Control Circuits diagram to updated flow/music version and remove old PNG
2026-08-14 straightening wires
2026-08-25 Add flowchart diagrams and inventory CSV
    [inventory.csv]
2026-08-25 Add audio-reactive LED firmware sketch for AtomS3
2026-08-26 Add light track analysis tool and example show
2026-08-29 Harden shower controller against admin-page freezes
    - Stage song PCM through a PSRAM ring buffer filled by the main loop so
    the Bluetooth A2DP task never touches the SD card (the SD/SPI stack is
    not task-safe; concurrent access could wedge the whole station)
    - Cache music channel file availability instead of 9 SD.exists() calls
    per status poll
    - Back off Bluetooth discovery after two minutes and retry one round
    every five minutes so endless inquiry scans stop starving the WiFi AP;
    add a "Find speaker" dashboard button to force a scan
    - Serve one /api/overview endpoint; dashboard polls it with a timeout
    and in-flight guard so it recovers instead of freezing
    - Subscribe the loop ta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
2026-08-29 Button start/stop shower flow, 10 s summary, wristband handoff, UI mockups
    - First button press starts water, second ends the shower (no more pump toggle)
    - Remove touchscreen END button; all input is wristband + button
    - Show gallons and elapsed time for 10 s after a shower ends
    - A different authorized wristband during a session ends it (HANDOFF) and logs the new member in
    - Add drawings/ui-mockups.html with circus, neon, desert motel and blackout themes
    - Update README and UI.md; add firmware/AGENTS.md
    Claude-Session: https://claude.ai/code/session_01FbgY5rite6Hb4bShoCowmt
2026-08-29 Add CampNet: ESP-NOW network across 4 stations and 2 door signs
    One Tough codebase now builds four station images (shower1, shower2,
    water_fill, rv_fill) from STATION_ID/STATION_ROLE build flags; fill roles
    compile out music, LEDs and the door sign. All stations and both NanoC6
    door signs share a router-free ESP-NOW broadcast link on a fixed channel
    (firmware/shared/CampNetProtocol.h, one copy of every wire constant).
    - USAGE snapshots: each station broadcasts its per-wristband totals; a
    UsageLedger (/NETUSAGE.CSV) merges them so the end-of-session screen
    shows this session, camp-wide total, and the shower/water/RV split.
    - MEMBERS sync: version-numbered whole-registry snapshots; enroll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
    [AdminServer.h, CampNet.cpp, CampNet.h, CampNetEspNow.h, CampNetProtocol.h, Config.h, MemberRegistry.cpp]
2026-08-29 CampNet: wire contract for single admin page (telemetry, commands, auth sync)
    Claude-Session: https://claude.ai/code/session_01VcgTy2En5zUnAwGm635Hf6
2026-08-30 CampNet: single admin page, authenticated remote commands, PSRAM headroom
    One login on any station now controls every station:
    - TELEMETRY (2 s / on change) and RECENT packets carry each station's
    state so the page renders per-station tabs from /api/stations.
    - COMMAND/ACK packets (HMAC-SHA256 over sender id + body with
    CampNet::SECRET, random nonce, per-sender replay window, retries until
    ACK, cached duplicate ACKs) run the same actions the local page has:
    enroll, calibration, music/speaker, end session, reboot. Nothing over
    the air can open a session or start the pump for one.
    - AUTH packet syncs the admin password hash (versioned) so there is one
    password for the camp.
    - /api/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
    [AdminServer.h, CampNet.cpp, CampNet.h, CampNetProtocol.h, Config.h, MemberRegistry.cpp, MemberRegistry.h]
2026-08-30 Add interactive six-device firmware uploader
2026-08-30 Add configurable relay power controls
2026-08-30 Redesign admin page as home screen + sub-pages (mockup C)
    Rebuild the phone-hosted admin dashboard around the light "daylight"
    layout from drawings/admin-mockups.html, adapted for the multi-station
    firmware: a sticky header with a priority live banner (enrollment,
    sessions in progress, station faults, controller not responding), a
    no-scroll home screen with an Enroll CTA and status/navigation tiles
    (members, water, one per station, camp settings), and focused pages for
    members (inline editor, no browser dialogs), water use, each station
    (session, recent sessions with reason chips, calibration, speaker, music
    knob, health, reboot) and camp settings (limits, CampNet peers, password).
    Destruct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
2026-08-30 Pre-burn verification fixes: WDT, registry sync, I2C recovery, storage
    - AdminServer: refuse audio uploads unless idle; feed the task WDT per
    chunk so multi-MB PCM uploads no longer reboot the station.
    - CampNet: stop recording a remote registry version per chunk; a station
    that missed a chunk could enrol at version+1 and wipe the registry
    camp-wide.
    - PulseStorage/SessionStorage: raise per-station tag tables 64 -> 100 to
    match MemberRegistry::MAX_MEMBERS.
    - main: I2C recovery re-opens the PaHUB and health-checks the RFID
    reader so hot re-plugs and reader brownouts recover without a reboot.
    - SettingsStore: restore SETTINGS.BAK if a brownout interrupted save().
    - platformio: pin Fa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
    [CampNet.cpp, PulseStorage.h, SessionStorage.h, SettingsStore.cpp, main.cpp]
2026-08-30 Pre-burn harden relay boot, storage, and dashboard
    [AdminServer.h, MemberRegistry.cpp, MemberRegistry.h, PulseStorage.cpp, PulseStorage.h, SessionStorage.cpp, SettingsStore.cpp]
2026-08-30 Reduce dashboard radio and heap pressure
2026-08-30 Configure two-meter shower LED strip
    [inventory.csv]
2026-08-30 Turn shower LEDs off while idle
2026-08-30 Correct shower strip to 120 addressable pixels
    [inventory.csv]
2026-08-30 Add five-second button reboot hold
    [Config.h, main.cpp]
2026-09-01 Add dead-man alarm, relay safety recovery, and boot forensics
    Field crashes leave the controller frozen with the pump relay latched on.
    Software cannot save the frozen station, so fail gracefully around it:
    - Dashboard dead-man alarm: surviving stations raise a top-priority red
    banner when a peer that last reported an active session goes silent for
    90 s, using the sessionActive flag STATUS already broadcasts.
    - Mid-session relay recovery: losing relay/hub control while water could
    be flowing now retries every 3 s and forces all outputs off on
    reconnect, ending the session with reason RELAY_RECOVERY.
    - I2C bus-clear at boot and in recovery so a slave left holding SDA by a
    mid-trans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
    [CampNet.cpp, CampNet.h, Config.h, I2cHub.cpp, I2cHub.h, RelayController.cpp, RelayController.h]
